TJLTM/MakeItRain/BOM/MakeItRain - Main Board - Bom.xls

Mfr Part Number (Input) | Quantity 1 | Mfr Part Number | Mouser Part Number | Manufacturer Name | Description | Unit Price 1 | Order Quantity | Order Unit Price | Min./Mult. | Availability | Lead Time in Days | Lead Time in Weeks | Lifecycle | NCNR | RoHS | Pb Free | Package Type | Package Quantity | Datasheet URL | Product Image | Design Risk
511-STPS3150RL | 4 | STPS3150RL | 511-STPS3150RL | STMicroelectronics | Schottky Diodes & Rectifiers Schottky Diodes & Rectifiers 3.0 Amp 150 Volt | $0.66 | 4 | $0.66 | 1\1 | 23,348 | 396 | 57 |  | No | Yes | No | REEL | 1,900 | https://www.mouser.com/datasheet/2/389/stps3150-1851493.pdf |  | Product has high popularity and is readily available.
579-MCP23008-E/P | 1 | MCP23008-E/P | 579-MCP23008-E/P | Microchip | Interface - I/O Expanders Interface - I/O Expanders In/Out I2C int | $1.54 | 1 | $1.54 | 1\1 | 1,979 | 301 | 43 |  | No | Yes | Yes | TUBE | 25 | https://www.mouser.com/datasheet/2/268/21919b-65915.pdf |  | Product has high popularity and is readily available.
512-2N7000 | 4 | 2N7000 | 512-2N7000 | onsemi | MOSFET MOSFET N-Channel Enhancement Mode Field Effect Transistor 60V, 200mA, 5 ohm | $0.52 | 4 | $0.52 | 1\1 |  | 423 | 61 |  | No | Yes | No | BULK | 10,000 | https://www.mouser.com/datasheet/2/308/1/NDS7002A_D-2317584.pdf |  | Product has high popularity and is readily available.
942-IRF9Z34NPBF | 5 | IRF9Z34NPBF | 942-IRF9Z34NPBF | Infineon | MOSFET MOSFET MOSFT PCh -55V -17A 100mOhm 23.3nC | $0.96 | 5 | $0.96 | 1\1 | 13,881 | 84 | 12 |  | No | Yes | Yes | TUBE | 1,000 | https://www.infineon.com/dgdl/Infineon-ApplicationNote_PowerMOSFET_SimulationModels-AN-v01_00-EN.pdf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 |  | Product has high popularity and is readily available.
512-BZX79C10 | 4 | BZX79C10 | 512-BZX79C10 | onsemi | Zener Diodes Zener Diodes 10V 0.5W Zener | $0.18 | 4 | $0.18 | 1\1 | 93,317 | 119 | 17 |  | No | Yes | No | BULK | 5,000 | https://www.mouser.com/datasheet/2/308/1/BZX79C2V4_D-2310197.pdf |  | Product has high popularity and is readily available.
859-LTV-846S | 1 | LTV-846S | 859-LTV-846S | Lite-On | Transistor Output Optocouplers Transistor Output Optocouplers Optocplr Phototrans 4-Channel | $1.00 | 1 | $1.00 | 1\1 | 92,716 | 84 | 12 |  | No | Yes | Yes | TUBE | 25 | https://www.mouser.com/datasheet/2/239/LTV_8X6_series-2887056.pdf |  | Product has high popularity and is readily available.
576-178.6165.0001 | 1 | 178.6165.0001 | 576-178.6165.0001 | Littelfuse | Fuse Holder Fuse Holder FUSEHOLDER FOR FLR | $4.62 | 1 | $4.62 | 1\1 | 11,055 | 147 | 21 |  | No | Yes | No | BULK | 100 | https://www.mouser.com/datasheet/2/240/Littelfuse_Fuse_Holder_ATO_FLR_pcb_Datasheet-1317199.pdf |  | Product has high popularity and is readily available.
179-TS0266160BK260LC | 1 | TS02-66-160-BK-260-LCR-D | 179-TS0266160BK260LC | CUI Devices | Tactile Switches Tactile Switches 6 x 6 mm, 16 mm Act Height, 260 gf, Black, Long Crimped, Through Hole, SPST, | $0.12 | 1 | $0.12 | 1\1 | 7,212 | 51 | 8 | New Product | No | Yes | No |  | 1,000 | https://www.mouser.com/datasheet/2/670/ts02-2586188.pdf |  | Product is new and is readily available.
651-17117251 | 1 | 1711725 | 651-1711725 | Phoenix Contact | Fixed Terminal Blocks Fixed Terminal Blocks 2P 5.08mm 90 DEG | $2.19 | 1 | $2.19 | 1\1 | 8,134 | 56 | 8 |  | No | Yes | No |  | 100 | https://www.phoenixcontact.com/us/products/1711725/pdf |  | Product has high popularity and is readily available.
652-3296W-1-504LF | 1 | 3296W-1-504LF | 652-3296W-1-504LF | Bourns | Trimmer Resistors - Through Hole Trimmer Resistors - Through Hole 3/8" 500Kohms Sealed Vertical Adjust | $2.43 | 1 | $2.43 | 1\1 | 2,464 | 49 | 7 |  | No | Yes | No | TUBE | 100 | https://www.mouser.com/datasheet/2/54/3296-776415.pdf |  | Product has high popularity and is readily available.
594-K224K20X7RF5UH5 | 4 | K224K20X7RF5UH5 | 594-K224K20X7RF5UH5 | Vishay | Multilayer Ceramic Capacitors MLCC - Leaded Multilayer Ceramic Capacitors MLCC - Leaded .22uF 50V 10% X7R 5mm LS | $0.43 | 4 | $0.43 | 1\1 | 19,750 | 105 | 15 |  | No | Yes | Yes | AMMO PACK | 2,500 | https://www.vishay.com/doc?45171 |  | Product has high popularity and is readily available.
595-OPA2340UA/2K5 | 1 | OPA2340UA/2K5 | 595-OPA2340UA/2K5 | Texas Instruments | Operational Amplifiers - Op Amps Operational Amplifiers - Op Amps Single-Supply Rail-to-Rail | $4.14 | 1 | $4.14 | 1\1 | 30,246 | 42 | 6 |  | No | Yes | No | REEL | 2,500 | https://www.ti.com/lit/pdf/sboz010a |  | Product has high popularity and is readily available.
603-CFR-25JT-52-22K | 4 | CFR-25JT-52-22K | 603-CFR-25JT-52-22K | YAGEO | Carbon Film Resistors - Through Hole Carbon Film Resistors - Through Hole 22 kOhms 250 mW 5% - 350/ +500 PPM / C | $0.10 | 4 | $0.10 | 1\1 | 16,256 | 196 | 28 |  | No | Yes | Yes | REEL | 5,000 | https://www.mouser.com/datasheet/2/447/YAGEO_CFR_datasheet_2021v0-3002993.pdf |  | Product has high popularity and is readily available.
603-CFR-25JT-52-100K | 4 | CFR-25JT-52-100K | 603-CFR-25JT-52-100K | YAGEO | Carbon Film Resistors - Through Hole Carbon Film Resistors - Through Hole 100 kOhms 250 mW 5% 0/-700PPM/ C | $0.10 | 4 | $0.10 | 1\1 | 41,401 | 196 | 28 |  | No | Yes | Yes | AMMO PACK | 5,000 | https://www.mouser.com/datasheet/2/447/YAGEO_CFR_datasheet_2021v0-3002993.pdf |  | Product has high popularity and is readily available.
603-CFR-25JT-52-10K | 7 | CFR-25JT-52-10K | 603-CFR-25JT-52-10K | YAGEO | Carbon Film Resistors - Through Hole Carbon Film Resistors - Through Hole 10 kOhms 250 mW 5% - 350/ +500 PPM / C | $0.11 | 7 | $0.11 | 1\1 | 1,447 | 196 | 28 |  | No | Yes | Yes | AMMO PACK | 5,000 | https://www.mouser.com/datasheet/2/447/YAGEO_CFR_datasheet_2021v0-3002993.pdf |  | Product has high popularity and is readily available.
603-CFR-25JT-52-330R | 5 | CFR-25JT-52-330R | 603-CFR-25JT-52-330R | YAGEO | Carbon Film Resistors - Through Hole Carbon Film Resistors - Through Hole 330ohm 5% 1/4W Carbon Film | $0.10 | 5 | $0.10 | 1\1 | 13,902 | 138 | 20 |  | No | Yes | Yes | REEL | 5,000 | https://www.mouser.com/datasheet/2/447/YAGEO_CFR_datasheet_2021v0-3002993.pdf |  | Product has high popularity and is readily available.
603-CFR-25JT-52-1M | 4 | CFR-25JT-52-1M | 603-CFR-25JT-52-1M | YAGEO | Carbon Film Resistors - Through Hole Carbon Film Resistors - Through Hole 1 MOhms 250 mW 5% -1500/ + 0 PPM / C | $0.10 | 4 | $0.10 | 1\1 | 10,713 | 171 | 25 |  | No | Yes | Yes | AMMO PACK | 5,000 | https://www.mouser.com/datasheet/2/447/YAGEO_CFR_datasheet_2021v0-3002993.pdf |  | Product has high popularity and is readily available.
603-CFR-25JT-52-15K | 1 | CFR-25JT-52-15K | 603-CFR-25JT-52-15K | YAGEO | Carbon Film Resistors - Through Hole Carbon Film Resistors - Through Hole 15Kohm 5% 1/4W Carbon Film | $0.10 | 1 | $0.10 | 1\1 | 5,583 | 110 | 16 |  | No | Yes | Yes | REEL | 5,000 | https://www.mouser.com/datasheet/2/447/YAGEO_CFR_datasheet_2021v0-3002993.pdf |  | Product has high popularity and is readily available.
603-CFR-25JT-52-120K | 1 | CFR-25JT-52-120K | 603-CFR-25JT-52-120K | YAGEO | Carbon Film Resistors - Through Hole Carbon Film Resistors - Through Hole | $0.10 | 1 | $0.10 | 1\1 | 1,758 | 112 | 16 |  | No | Yes | Yes |  |  | https://www.mouser.com/datasheet/2/447/YAGEO_CFR_datasheet_2021v0-3002993.pdf |  | Product has high popularity and is readily available.
603-CFR-25JT-52-47K | 2 | CFR-25JT-52-47K | 603-CFR-25JT-52-47K | YAGEO | Carbon Film Resistors - Through Hole Carbon Film Resistors - Through Hole 47Kohm 5% 1/4W Carbon Film | $0.10 | 2 | $0.10 | 1\1 | 1,723 | 95 | 14 |  | No | Yes | Yes | REEL | 5,000 | https://www.mouser.com/datasheet/2/447/YAGEO_CFR_datasheet_2021v0-3002993.pdf |  | Product has high popularity and is readily available.
CFR-25JT-52-2K2 | 2 | CFR-25JT-52-2K2 | 603-CFR-25JT-52-2K2 | YAGEO | Carbon Film Resistors - Through Hole Carbon Film Resistors - Through Hole 2.2 kOhms 250 mW 5% -350/ +500 PPM / C | $0.10 | 2 | $0.10 | 1\1 | 21,704 | 224 | 32 |  | No | Yes | Yes | AMMO PACK | 5,000 | https://www.mouser.com/datasheet/2/447/YAGEO_CFR_datasheet_2021v0-3002993.pdf |  | Product has high popularity and is readily available.
571-1-2199298-5 | 1 | 1-2199298-5 | 571-1-2199298-5 | TE Connectivity | IC & Component Sockets IC & Component Sockets 18P DIP SKT 300 CL LADDER | $0.38 | 1 | $0.38 | 1\1 | 7,079 | 88 | 13 |  | No | Yes | Yes | TUBE | 2,600 | https://www.mouser.com/catalog/additional/Tyco Electronics_1-1773906-9_DIP_Socket_QRG_012017.pdf |  | Product has high popularity and is readily available.
78-TLLG4400-AS12 | 1 | TLLG4400-AS12 | 78-TLLG4400-AS12 | Vishay | Standard LEDs - Through Hole Standard LEDs - Through Hole Green; 1.2mcd; 3mm 562-575nm; 1.9V Typ | $0.51 | 1 | $0.51 | 1\1 | 13,179 | 119 | 17 |  | No | Yes | Yes |  | 10,000 | https://www.vishay.com/doc?84892 |  | Product has high popularity and is readily available.
522-BS250P | 4 | BS250P | 522-BS250P | Diodes Incorporated | MOSFET MOSFET P-Chnl 45V | $0.89 | 4 | $0.89 | 1\1 | 6,900 | 314 | 45 |  | No | Yes | Yes | BULK | 4,000 | https://www.diodes.com/assets/Datasheets/BS250P.pdf |  | Product has high popularity and is readily available.
651-1714735 | 4 | 1714735 | 651-1714735 | Phoenix Contact | Fixed Terminal Blocks Fixed Terminal Blocks 3 POS 5.08mm SP. | $3.47 | 4 | $3.47 | 1\1 | 836 | 42 | 6 |  | No | Yes | No |  | 50 | https://www.phoenixcontact.com/us/products/1714735/pdf |  | Product has moderate popularity and is readily available.
517-929974-01-19-RK | 2 | 929974-01-16-RK | 517-929974-01-16-RK | 3M | Headers & Wire Housings Headers & Wire Housings 16 CON STR BRDMNT SKT | $2.61 | 2 | $2.61 | 1\1 | 1,389 | 35 | 5 |  | No | Yes | No |  | 360 | https://www.mouser.com/datasheet/2/1/991ec32a691ced7668842f5090ff38d9635d6388-2952179.pdf |  | Product has high popularity and is readily available.
