TJLTM/MakeItRain/Docs/HW Verification for BaseBoard.ods

Zone | Input | Output
1
2
3
4
LED
Button
Aux Voltage
VS Voltage
Extra IO | Test as Output
Z5
Z6
Z7
Z8
