TJLTM/MakeItRain/(threads)

Thread 1 (2021-10-10):

turn Power fets around to allow for a heat sink.

TJLTM, 2021-10-10:
if they are turned around then this will allow for a heat sink to be installed to allow more current.

TJLTM, 2021-10-12:
Did this i haven't designed the heat sink that will fit across all the FETs including the Reverse polarity protection fet

Closed 2021-10-12.

Thread 3 (2021-11-08):

Debounce the input pins

TJLTM, 2021-11-08:
they are a little touchy need to have a slight hardware mod to correct this along with some FW

TJLTM, 2021-11-25:
tested this with a hardware mod to the current boards this looks to be fixed.

Closed 2021-11-25.

Thread 4 (2021-11-22):

when local inputs are toggled with Current code this causes restart

TJLTM, 2021-11-22:
When triggering these ISR for the local inputs it causes a core to panic and thus causes a restart/reboot of the processor.

TJLTM, 2021-11-25:
In my laziness i was triggering an MQTT publish within a ISR for the Local input zone control. fixed that with some flag setting and updates outside of the ISR. It doesn't cause a core panic/restart with commit: 1574a7fd6202a83d2789cc866ac36614299d7460

Closed 2021-11-25.

Thread 5 (2021-11-22):

When starting initializing the Pins as outputs causes them to drive high and will trigger the outputs to be on for approx 0.5 seconds

TJLTM, 2021-11-22:
Not sure what i have to do to fix this issue. Could be in code or in hardware. Not sure if it can be fixed in either case without having a separate enable output circuit.

TJLTM, 2022-03-30:
so this may be a ESP-32 hardware quirk (one of many it seems) that you can't work around. It looks like when you setup pin-modes they drive the pins high for ~100 mS while the Pull-ups and all the other port stuff are set up.

Closed 2022-03-30.

Thread 6 (2021-12-30):

add opto-isolation to the Input Circuits.

TJLTM, 2021-12-30:
I use the same input on CampKeen and that has a way of burning out the GPIO If there is an external and separate Voltage source is used to trigger the Input. probably won't affect this board but can't hurt.

Closed 2022-02-02.

Thread 8 (2022-01-06):

update schematic so that spare pins include I2C bus

TJLTM, 2022-01-06:
i haven't looked yet. but i think i have to move some pins around as to have the I2C bus free to be used on a daughter board.

Closed 2022-02-02.

Thread 10 (2022-03-22):

RTC on version 1.0 hardware isn't working correctly

TJLTM, 2022-03-22:
i have to figure out if this is an ESP or hardware issue.

TJLTM, 2022-03-30:
working theory for this is in the fact that the power draw when on WIFI causes current limitations/voltage drop on the I2C bus that cause higher noise on the lines. This may require stronger Pull-ups on the I2C bus. or some other hardware modification to get the capacitance into spec.

TJLTM, 2022-04-08:
removing the DS3231 RTC and using the Internal RTC since there is a LIB for it.

Closed 2022-04-08.

Thread 16 (2022-04-19):

Design Daughter Board for Power

TJLTM, 2022-04-19:
due to trouble sourcing LM2597-5.0 chips I'm going to make the 5V power source a daughter/sub board that can be switched out to another chip if needed OR allow it to take in AC Voltage sources. I have not tested or tried that yet.

TJLTM, 2022-07-19:
design 3.3v output board as well. AC may not be able to be done as that may need to change out the reverse protection and zone outputs. i would have to switch from solid state to relay for that to be done.

TJLTM, 2022-10-06:
scratch that redesign for #22 shows that i no longer need to have 5v just 3.3v. way to resolve this is to remove 5v completely from the main board and if power is needed on the daughterboard they can pull power from that while leaving the main boards power alone.

TJLTM, 2023-04-26:
designed one in a separate repo https://github.com/TJLTM/LM2670SX-3.3-Carrier

Closed 2023-04-26.

Thread 21 (2022-06-13):

Investigate MPPT solar chargers

TJLTM, 2022-06-13:
Dogfooding one of these units and has caused the power subsystem to have faults. Pretty sure this is related to the PWM of this charger and i need to look at filtering the power.

TJLTM, 2022-10-06:
#22 and #16  will probably fix this one as the ESP32 is a power hungry little chip that needs ~4watts of power and the 2.5w that the reg can output causes it to burn out over time not the MPPT solar charger for the battery. will keep an eye on this after the power redeisng

TJLTM, 2023-05-16:
Closing this issue for now since. it looks like it was never MPPT chargers and the voltage regulator on the board. If issues come back up we'll reopen this issue and address it.

Closed 2023-05-16.

Thread 22 (2022-08-21):

on boot ESP doesn't finish booting and has a zone (3) stay on.

TJLTM, 2022-08-21:
investigating when i lost power and it came back up that makeitrain would not finish booting and would have zone 3 stay on.

TJLTM, 2022-08-21:
Add to Docs or fix in HW that the EN pin can't be left floating and must be tied high or snipped from Dev board to stop this. as well as removing one ground pin that seems to cause the same issue. that requires some further investigation.

TJLTM, 2022-08-23:
further investigation is showing that this may be a partial fix. to solve this problem may use another GPIO pin to enable the outputs

Closed 2023-05-19.

Thread 23 (2022-10-06):

rework the daughterboard templates.

TJLTM, 2022-10-06:
fixing the boot and pin issues will require these to be updated to work.

TJLTM, 2023-04-26:
updated and finished in #22 branch

Closed 2023-04-26.

Thread 24 (2022-12-20):

Go over CheckStoredData() for anything that could cause issues

TJLTM, 2022-12-20:
Check to see if an invalid state can be set in here and cause the ESP32 to crash.

Thread 25 (2023-01-03):

Add Safety for 3.3v input to board

TJLTM, 2023-01-03:
Realized that the input to the 3.3v needs protection against
-- Overvoltage 3.7
-- reverse polarity?

TJLTM, 2023-05-16:
Closing because of the following reasons
* reverse polarity is down stream and if someone hooks up things incorrectly.... well bad things happen
*  Overvoltage protection could be added but adds complexity and uses up some real estate and is a bit of edge case since if the regulator goes bad in more other systems it's fired.

Closed 2023-05-16.

Thread 26 (2023-01-06):

Replace OPA2340PA with OPA2340UA/2K5

TJLTM, 2023-01-06:
OPA2340PA is no longer made.

TJLTM, 2023-01-15:
OPA2340UA/2K5 is an SMT/D pin compatible package of the same family, for 1.3.x boards i'm going to use a dip to smt/d pcb. 1.4 boards are going to get this fix.

TJLTM, 2023-04-26:
replaced in #22 branch

Closed 2023-04-26.

Thread 27 (2023-03-27):

Fix Wifi Reconnect Logic

TJLTM, 2023-03-27:
Needs to be reworked that it will continue to try but at a backed off rate.
Current workflow is after x times of trying it stops and turns on AP and BT (when BT feature is done that is)

Keep X tries and then turn on BT and AP mode but continue trying and if it reconnects then turn off BT/AP if they were already disabled.

Closed 2024-01-28.

Thread 31 (2023-05-23):

HW Determine if input circuit is faulty or if PCB routing is to blame

TJLTM, 2023-05-23:
Inputs on 1.3.2/3 boards act as if shorted.

TJLTM, 2023-06-12:
check your parts the parts i bought for this after searching their datasheets and manu dont' say that the -BU and the -SP part numbers denotes a 3P being a single connection instead of 3P that are independent.

Closed 2023-07-14.

Thread 32 (2023-07-25):

HW Improvement: Input Impedance

TJLTM, 2023-07-25:
add a Nchannel fet after the Pchannel on the input to raise the input impedance a merger of the last and current designs. Doesn't need to be implemented for release but will fix other use cases that i only seem to have.

Thread 33 (2024-02-04):

Local control toggle and MQTT update bug

TJLTM, 2024-02-04:
when enabled MQTT update goes into a loop for the update and partially locks up the ESP32
