TJLTM/MakeItRain/(list of files, drawings)

Other design files:
Hardware/MIR-InputMod/MIR-InputMod.dsn
