TJLTM/MakeItRain/Code/Tools And Test/HardwareValidation/HardwareValidation.ino

#include <Wire.h>
#include <Adafruit_MCP23X08.h>

#define I2C_SDA_PIN 23
#define I2C_SCL_PIN 22
Adafruit_MCP23X08 GPIOEX;
bool GrootToGo = true;

#define VSVoltagePin 33
#define AUXVoltagePin 32
#define ResetButton 25
#define LEDOut 27

#define Zone1Input 34
#define Zone2Input 35
#define Zone3Input 36
#define Zone4Input 39

void setup() {
  Serial.begin(9600);
  //Wire.begin(I2C_SDA_PIN, I2C_SCL_PIN);
  //Wire.setClock(100000);
  if (!GPIOEX.begin_I2C()) {
    Serial.println("Error can not communicate to MCP23008");
    GrootToGo = false;
  }
  else {
    GPIOEX.pinMode(0, OUTPUT); //Zone 1
    GPIOEX.pinMode(1, OUTPUT); //Zone 2
    GPIOEX.pinMode(2, OUTPUT); //Zone 3
    GPIOEX.pinMode(3, OUTPUT); //Zone 4
    GPIOEX.pinMode(4, OUTPUT); //Zone 5
    GPIOEX.pinMode(5, OUTPUT); //Zone 6
    GPIOEX.pinMode(6, OUTPUT); //Zone 7
    GPIOEX.pinMode(7, OUTPUT); //Zone 8
  }

  pinMode(LEDOut, OUTPUT);
  pinMode(ResetButton, INPUT);
  pinMode(Zone1Input, INPUT);
  pinMode(Zone2Input, INPUT);
  pinMode(Zone3Input, INPUT);
  pinMode(Zone4Input, INPUT);
}

void loop() {
  //ButtonCheck();
  //ReadADCs();
  //ReadAllInputs();
  //ReadAllInputsIndivialDisplay();
  //OutputWalk();
  
  /*
    OutputBlink(0,2000);
    OutputBlink(1,2000);
    OutputBlink(2,2000);
    OutputBlink(3,2000);
    OutputBlink(4,2000);
    OutputBlink(5,2000);
    OutputBlink(6,2000);
    OutputBlink(7,2000);
  */
}

void ButtonCheck() {
  int ButtonRead = digitalRead(ResetButton);
  Serial.print("Reset Button State:");
  Serial.println(ButtonRead);
  digitalWrite(LEDOut, digitalRead(ResetButton));
}

void ReadADCs() {
  Serial.print("AUX Voltage:");
  Serial.println(analogRead(AUXVoltagePin));
  Serial.print("VS Voltage DN:");
  Serial.println(analogRead(VSVoltagePin));
  float Voltage = (30.954 / 4095) * analogRead(VSVoltagePin);
  Serial.print("VS Voltage Calc:");
  Serial.println(Voltage);
  delay(2500);
}

void ReadAllInputs() {
  byte Inputs;

  bitWrite(Inputs, 0, digitalRead(Zone1Input));
  bitWrite(Inputs, 1, digitalRead(Zone2Input));
  bitWrite(Inputs, 2, digitalRead(Zone3Input));
  bitWrite(Inputs, 3, digitalRead(Zone4Input));

  Serial.print("Inputs:");
  Serial.println(Inputs);
  delay(1000);
}


void ReadAllInputsIndivialDisplay() {
  Serial.print("Input1:");
  Serial.println(digitalRead(Zone1Input));

  Serial.print("Input2:");
  Serial.println(digitalRead(Zone2Input));

  Serial.print("Input3:");
  Serial.println(digitalRead(Zone3Input));

  Serial.print("Input4:");
  Serial.println(digitalRead(Zone4Input));
  
  delay(1000);
}

void OutputWalk() {
  for (int x = 0; x < 8; x++) {
    OutputBlink(x, 2000);
  }
}

void OutputBlink(int PortNumber, float Time) {
  String Message = "Zone " + String(PortNumber) + " Output ";
  Serial.println(Message + "High");
  SetOutput(PortNumber, HIGH);
  delay(Time);
  Serial.println(Message + "LOW");
  SetOutput(PortNumber, LOW);
  delay(Time);
}


void SetOutput(int PortNumber, bool State) {
  if (GrootToGo == true) {
    GPIOEX.digitalWrite(PortNumber, State);
  }
  else {
    Serial.println("Can Not communicate with MCP23008");
  }
}
