TJLTM/MakeItRain/(commit log)

2021-09-20 initial blank HW Project
    [MakeItRain.kicad_pcb, MakeItRain.sch]
2021-09-22 stopping point as i need to test the voltage sensor and also see what the power draw is for this so far. I may have to bump the power reg to something with more power.
    [file61506092.sch, file6158F2C3.sch]
2021-09-26 WIP to test some hardware designs.
    [MakeItRain.kicad_pcb, MakeItRain.sch]
2021-10-05 wip for layout
    [MakeItRain.kicad_pcb, MakeItRain.sch, file61506092.sch]
2021-10-05 updated to have only up to 4 additional zones with a separate board.
    [MakeItRain.kicad_pcb, MakeItRain.sch]
2021-10-06 Routing Done need to add some more documentation to the board via silkscreen.
    [MakeItRain.kicad_pcb, MakeItRain.sch, file61506092.sch]
2021-10-07 Fixed a few fuck up on the board and schematic. a label wasn't correct and thus wasn't routed. Changed the VDC power to the zones from a 40mil trace to a plane. added silkscreen stuff to the board.
    [MakeItRain-B_Cu.gbr, MakeItRain-B_Mask.gbr, MakeItRain-B_Paste.gbr, MakeItRain-B_SilkS.gbr, MakeItRain-Edge_Cuts.gbr, MakeItRain-F_Cu.gbr, MakeItRain-F_Mask.gbr, MakeItRain-F_Paste.gbr]
2021-10-07 fixed the silkscreen stuff on the fab files
    [MakeItRain-B_Cu.gbr, MakeItRain-B_Mask.gbr, MakeItRain-B_Paste.gbr, MakeItRain-B_SilkS.gbr, MakeItRain-Edge_Cuts.gbr, MakeItRain-F_Cu.gbr, MakeItRain-F_Mask.gbr, MakeItRain-F_Paste.gbr]
2021-10-12 WIP for HW fixed a few things like positions of the Power Fets so they can have a Heat sink. Added holes for mounting daughter boards. Feed Trace to Q1 was beefed up to wide zone from 10mils this is 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
    [MakeItRain.kicad_pcb]
2021-10-21 putting in correct pins and Hardware Verification sketch.
    [HardwareValidation.ino]
2021-10-21 updated resistor values on the boards that weren't defined.
    [MakeItRain.kicad_pcb, MakeItRain.sch]
2021-10-24 adding bom and
    [MakeItRain.csv]
2021-10-25 fixing a hole placement and routing.
    [MakeItRain.kicad_pcb]
2021-10-25 FW for using interrupts for the local control. needs to be tested.
2021-10-27 updated some missing values on the schematic.
    [MakeItRain.sch, file61506092.sch]
2021-10-30 updated fab files and some values on the schematic. this is to fix the problem with grounding one of the ground pins and it affecting the dev board running and being able to load.
    [MakeItRain-B_Cu.gbr, MakeItRain-B_Mask.gbr, MakeItRain-B_Paste.gbr, MakeItRain-B_SilkS.gbr, MakeItRain-Edge_Cuts.gbr, MakeItRain-F_Cu.gbr, MakeItRain-F_Mask.gbr, MakeItRain-F_Paste.gbr]
2021-11-02 fixed the battery voltage read. removing some comments and removing outputs 7 & 8 as those won't be needed changing the ideas for the Daughterboard.
2021-11-14 adding timer and whatnot.
2021-11-14 fixed mqtt communication need to get the mqtt to zone switch on change to work.
2021-11-16 adding the debounce caps haven't moved some stuff around on the board to fit these in.
    [MakeItRain.kicad_pcb, file61506092.sch]
2021-11-17 added the debounce caps to the layout and updated the fab files for this version.
    [MakeItRain-B_Cu.gbr, MakeItRain-B_Mask.gbr, MakeItRain-B_Paste.gbr, MakeItRain-B_SilkS.gbr, MakeItRain-Edge_Cuts.gbr, MakeItRain-F_Cu.gbr, MakeItRain-F_Mask.gbr, MakeItRain-F_Paste.gbr]
2021-11-25 Some performance/message throttling is probably needed but this is currently working. Tested with a debounce modification on the input and that seems to have fixed the input bouncing problem. I see m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
2022-01-09 update to kicad 6.0 and start on adding in opto-isolationg to the inputs as to protect the processor GPIO
    [MakeItRain.kicad_pcb]
2022-01-09 working on adding the opto-isolators
    [MakeItRain.kicad_sch, file61506092.kicad_sch]
2022-01-09 wip for hardware
    [InputIsolation.kicad_sch, MakeItRain.kicad_pcb, MakeItRain.kicad_sch, Power.kicad_sch, VoltageSensors.kicad_sch, file61506092.kicad_sch]
2022-01-10 cleaning up the files after the KIcad Project upgrade
    [MakeItRain.csv, MakeItRain.sch, file61506092.sch, file6158F2C3.sch]
2022-01-25 wip for input fix.
    [InputIsolation.kicad_sch, MakeItRain.kicad_pcb, MakeItRain.kicad_sch, Power.kicad_sch, VoltageSensors.kicad_sch, file61506092.kicad_sch]
2022-02-02 pre routing
    [InputIsolation.kicad_sch, MakeItRain.kicad_pcb, MakeItRain.kicad_sch, VoltageSensors.kicad_sch, file61506092.kicad_sch]
2022-02-02 fixed some redundant routing
    [MakeItRain.kicad_pcb]
2022-02-02 updated fab files
    [MakeItRain-B_Cu.gbr, MakeItRain-B_Mask.gbr, MakeItRain-B_Paste.gbr, MakeItRain-B_Silkscreen.gbr, MakeItRain-Edge_Cuts.gbr, MakeItRain-F_Cu.gbr, MakeItRain-F_Mask.gbr, MakeItRain-F_Paste.gbr]
2022-02-19 updating the fab files so they can be sent off.
    [MakeItRain-B_Cu.gbr, MakeItRain-B_Mask.gbr, MakeItRain-B_Paste.gbr, MakeItRain-B_Silkscreen.gbr, MakeItRain-Edge_Cuts.gbr, MakeItRain-F_Cu.gbr, MakeItRain-F_Mask.gbr, MakeItRain-F_Paste.gbr]
2022-02-21 updating fab files.
    [MakeItRain-B_Adhesive.gbr, MakeItRain-B_Courtyard.gbr, MakeItRain-B_Cu.gbr, MakeItRain-B_Fab.gbr, MakeItRain-B_Mask.gbr, MakeItRain-B_Paste.gbr, MakeItRain-Edge_Cuts.gbr, MakeItRain-F_Adhesive.gbr]
2022-03-21 adding HTML BOM
2022-03-22 updated values for the InputIsolation circuits. updated the PCB values and BOM. Updating the Hardware Validation program.
    [InputIsolation.kicad_sch, MakeItRain.kicad_pcb, MakeItRain.kicad_sch]
2022-03-22 working on fixing the verification program. updating the main fw to have the correct pins. removing the daughterboard sensing and adding RTCBattery voltage sensing.
    [HardwareValidation.ino]
2022-03-29 switching the interrupts to be failing as the inputs are inverted from previous design.
2022-03-29 autoformat, added max zone on time (to cover connection loss after turned on), fixed Voltage Readings.
2022-03-30 switching out Serial for a central place for that. changed the mqtt connection name to be that of the ID so there isn't a conflict on the MQTT server. fixed some timer issues and added a 15 second ti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
2022-03-30 autoformat, added Wifitry again timer Tries every 15 mins after max attempts in a row, a five second timer for throttling the can't connect to wifi message, fixed voltage reads to be every 30 seconds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
2022-04-01 production build for ESP32
2022-04-01 reduced file names for ESP32
2022-04-02 changing the name of the 30 second timer to Votlage timer and changing from 30 seconds to every 2 mins. may make this configurable.
2022-04-03 organizing some code. putting in AP framework and logic. adding in Settings and Reset functions. IP Settings.
2022-04-09 working on factory resets and setting up default information. along with adding in a battery mode to incorporate sleep modes (start of nothing works with it yet)
2022-04-09 removing RTC battery voltage and adding Battery mode to system settings.
2022-04-09 wip for removing the external RTC and moving the power stuff around to make it easier to install into enclosure.
    [MakeItRain.kicad_pcb, MakeItRain.kicad_sch]
2022-04-10 continuing on moving the parts around the board to make installation into the SERPAC RBF63XXXX series enclosure easier.
    [MakeItRain.kicad_pcb]
2022-04-11 adding v0.1 HW support since i'm Deving some stuff on those boards, fixing some of the WIFI/AP mode stuff. Removing RTC Battery Stuff.
2022-04-11 Routed. DRC'ed. and Fab Files have been updated.
    [MakeItRain-B_Cu.gbr, MakeItRain-B_Mask.gbr, MakeItRain-B_Paste.gbr, MakeItRain-B_Silkscreen.gbr, MakeItRain-Edge_Cuts.gbr, MakeItRain-F_Cu.gbr, MakeItRain-F_Mask.gbr, MakeItRain-F_Paste.gbr]
2022-04-11 stubbed in some AP mode stuff. cleaned up some unused timer vars and stubbing in battery mode stuff.
2022-04-12 fixed the oldhw pin def and logic.
2022-04-15 due to lack of chips (LM2597) i'm switching (no pun intended) to having the power system be a daughter board that can be plugged in once i find some replacements.
    [MakeItRain.kicad_pcb, MakeItRain.kicad_sch, Power.kicad_sch]
2022-04-19 bumped Version on silkscreen to 1.2. Still need to place some mounting holes if needed for the power daughter board.
    [MakeItRain.kicad_pcb]
2022-04-22 trying a behavior change. When starting up and subscribing to MQTT not pushing the current status of the outputs letting whats on the MQTT topic over ride and set local.
2022-05-01 autoformat. yes i do that a lot. white space formatting pleases my python writing mind. working on the wifi and ap connection stuff and how it's suppose to work. currently it will turn on the AP mode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
    [MakeItRain-FW.ino]
2022-05-13 adding a daughterboard blank kicad project with board outline.
    [MakeItRain - DaughterBoard Blank.kicad_pcb, MakeItRain - DaughterBoard Blank.kicad_sch]
2022-05-27 initial working on wifi stuff. some logic for wifi vs ap and other bugs that may have been related to a dying ESP32
    [MakeItRain-FW.ino]
2022-05-28 fixed some of the MQTT stuff and moved a lot of logic down into one function that is called. fixed some of the ISR stuff so it won't be called on start up. added a debug heartbeat serial print for th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
    [MakeItRain-FW.ino]
2022-05-28 added feature to set IDs added the print out of wifi ip on serial. removed once try from MQTT send if disconnected. this probably isn't that important because when it comes back online with mqtt it w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
2022-05-30 removing some print statements streamlining MQTTSend to only try to send with it's enabled and the client is connected. added logic that forces the AP on if the Wifi is turned off.
2022-07-06 updating the fab files. and removing hte ones that aren't needed.
    [MakeItRain-B_Adhesive.gbr, MakeItRain-B_Courtyard.gbr, MakeItRain-B_Cu.gbr, MakeItRain-B_Fab.gbr, MakeItRain-B_Mask.gbr, MakeItRain-B_Paste.gbr, MakeItRain-B_SilkS.gbr, MakeItRain-B_Silkscreen.gbr]
2022-07-11 updated Silkscreen to have the power header values. updated Fab Files.
    [MakeItRain-B_Cu.gbr, MakeItRain-B_Mask.gbr, MakeItRain-B_Paste.gbr, MakeItRain-B_Silkscreen.gbr, MakeItRain-Edge_Cuts.gbr, MakeItRain-F_Cu.gbr, MakeItRain-F_Mask.gbr, MakeItRain-F_Paste.gbr]
2022-07-19 Starting on Zone expansion daughter board.
    [MakeItRain - DaughterBoard Blank.kicad_pcb]
2022-07-19 moved fab files into sub folder for main board added to schematics for zones. copy pasta! need to place and route on PCB
    [MakeItRain - DaughterBoard Blank.kicad_pcb, MakeItRain - DaughterBoard Blank.kicad_sch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]
2022-07-19 adding support for Zone Expansion daughter board to FW finished daughter board design and pcb layout added fab files for zone expansion daughter board
    [MakeItRain - DaughterBoard Blank-B_Cu.gbr, MakeItRain - DaughterBoard Blank-B_Mask.gbr, MakeItRain - DaughterBoard Blank-B_Paste.gbr, MakeItRain - DaughterBoard Blank-B_Silkscreen.gbr, MakeItRain - DaughterBoard Blank-Edge_Cuts.gbr, MakeItRain - DaughterBoard Blank-F_Cu.gbr, MakeItRain - DaughterBoard Blank-F_Mask.gbr, MakeItRain - DaughterBoard Blank-F_Paste.gbr]
2022-07-20 updating BOM removing some old hardware defs from the code fixing the wip for expansion zones.
    [MakeItRain-FW.ino]
2022-08-23 Update MakeItRain-FW.ino
    going over some of the ESP32 docs and seeing that some pins will have to be remapped as they are causing some issues. sometimes these chips aren't worth the headaches they cause with all their gotchas.
    [MakeItRain-FW.ino]
2022-09-29 working on pin reassignment to fix the stupid stupid ways that esp32 are designed in hardware that require much in way of digging through docs cause not all gpio are created equal.
    [MakeItRain.kicad_sch, VoltageSensors.kicad_sch, file61506092.kicad_sch]
2022-09-29 cleaned up PCB of traces that have been deleted in the schematic.
    [MakeItRain.kicad_pcb]
2022-09-29 min updates on schem. wip
    [MakeItRain.kicad_sch, file61506092.kicad_sch]
2022-10-02 starting to add in the mcp23008 to get around the lack of pins or "special" pins that will fuck up designs. stupid ESP32s
    [MakeItRain.kicad_sch, file61506092.kicad_sch]
2022-10-02 i think i have the pins finally figured out. Need to breadboard this setup to make sure it works.
    [MakeItRain.kicad_sch, VoltageSensors.kicad_sch]
2022-10-05 replacing the daughterboard plug
    [MakeItRain.kicad_sch]
2022-10-06 working on getting the test code for the MCP23008 into the fw. working on the pins and getting all of that stuff placed on the PCB.
    [MakeItRain.kicad_pcb, MakeItRain.kicad_sch]
2022-10-07 removed the 5V on the baseboard and daughterboard plug.
    [MakeItRain.kicad_pcb, MakeItRain.kicad_sch, Power.kicad_sch]
2022-10-07 fixed the 3d shapes for various parts
    [MakeItRain.kicad_pcb]
2022-10-07 updating some routes, updating the already done daughterboard and updating the blank layout for both.
    [MakeItRain - DaughterBoard Blank.kicad_pcb, MakeItRain - DaughterBoard Blank.kicad_sch, MakeItRain.kicad_pcb]
2022-10-23 Moving into the prototyping testing this deisgn completely phase.
    changes
    * remapping some pins cause i forgot that ADC2 can not be used while using wifi.
    * adding the TH version of the MCP230008 as i don't know the availability of these chips can populate one or the other
    * removed zones 5-8 in the code since i hhaven't figured out the daughter board yet. Code not included can be buggy
    [MakeItRain.kicad_pcb, MakeItRain.kicad_sch, VoltageSensors.kicad_sch]
2022-11-27 fixing this testing verification code to be in line with the changes made. *Adding MCP23008 support *Removing RTC testing as that is internal to the ESP32
    [HardwareValidation.ino]
2022-11-28 moving some things around.
    [MakeItRain.kicad_pcb]
2022-11-28 fixed the MCP code.
    [HardwareValidation.ino]
2022-11-28 placing parts
    [MakeItRain.kicad_pcb]
2022-12-12 partial routing need to finish out the remainder.
    [MakeItRain.kicad_pcb]
2022-12-13 almost finished some routes
    [MakeItRain.kicad_pcb]
2022-12-14 Finished routing, DRC'ed and new Fab Files. Need one more once over to check before sending off to FAB
    [MakeItRain-B_Cu.gbr, MakeItRain-B_Mask.gbr, MakeItRain-B_Paste.gbr, MakeItRain-B_Silkscreen.gbr, MakeItRain-Edge_Cuts.gbr, MakeItRain-F_Cu.gbr, MakeItRain-F_Mask.gbr, MakeItRain-F_Paste.gbr]
2022-12-20 * Adding Doc for whats stored in eeprom * fixing some names for items stored in eeprom * moving some of the code around for house keeping.
    [stored settings.ods]
2022-12-31 updated BOM
2023-01-05 in the process of cleaning up the HardwareValidation.ino and fixing a major fuck up for the board. misread a pin header.
    [MakeItRain.kicad_sch]
2023-01-05 fixed GND connected to CMD pin * updated schematic * fixed PCB routing * updated Fab files * bumped board rev to 1.3.1
    [MakeItRain-B_Cu.gbr, MakeItRain-B_Mask.gbr, MakeItRain-B_Paste.gbr, MakeItRain-B_Silkscreen.gbr, MakeItRain-Edge_Cuts.gbr, MakeItRain-F_Cu.gbr, MakeItRain-F_Mask.gbr, MakeItRain-F_Paste.gbr]
2023-01-10 adding checklist for base board
    [HW Verification for BaseBoard.ods]
2023-02-26 upgrading the project to KiCAD 7
    [InputIsolation.kicad_sch, MakeItRain.kicad_pcb, MakeItRain.kicad_sch, Power.kicad_sch, VoltageSensors.kicad_sch, file61506092.kicad_sch]
2023-03-03 upgrade to kicad 7, updated bom/ibom.html
2023-04-10 adding some MCP can't be communicated to failure checks and bypass logic and error posting. Needs some more checks.
    [MakeItRain-FW.ino]
2023-04-17 WIP - Pre Re-Routing and other Tweaks.
    * Removed SMD package for the MCP23008
    * removed routings to fix the routes for I2C bus
    * flipped rx/tx with SDA/SCL on the expansion port to make routing easier.
    [MakeItRain.kicad_pcb, MakeItRain.kicad_sch, file61506092.kicad_sch]
2023-04-17 tweaking Test Code/Tools And Test/HardwareValidation/HardwareValidation.ino
    * adding I2C bus communication problem notifications
    * testing some i2c bus speed settings.
    [HardwareValidation.ino]
2023-04-18 wip for routing
    [MakeItRain.kicad_pcb]
2023-04-25 fixing routings
    [MakeItRain.kicad_pcb]
2023-04-26 MakeItRain * Main Board Fixed Routing. * replaced Opamp with the part that i can get as the old one is EOL * generated all the fab files i need. * updated the daughter plug witht eh i2c ttl flip * fi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
    MakeItRain - DaughterBoard - Zone Expansion
    * updated the daughter plug witht eh i2c ttl flip
    * fixed some of the routings
    * generated new fab files
    * DRC'ed the board
    [InputIsolation.kicad_sch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]
2023-04-29 Updating HTML assembly bom adding Mouser generated bom
    [MakeItRain - 4 Zone Expansion - Bom.xls, MakeItRain - Maine Board - Bom.xls]
2023-05-06 removing a timer that isn't used.
2023-05-06 updating the position of one daughter board mounting holes.
    [MakeItRain - DaughterBoard Blank-B_Cu.gbr, MakeItRain - DaughterBoard Blank-B_Mask.gbr, MakeItRain - DaughterBoard Blank-B_Paste.gbr, MakeItRain - DaughterBoard Blank-B_Silkscreen.gbr, MakeItRain - DaughterBoard Blank-Edge_Cuts.gbr, MakeItRain - DaughterBoard Blank-F_Cu.gbr, MakeItRain - DaughterBoard Blank-F_Mask.gbr, MakeItRain - DaughterBoard Blank-F_Paste.gbr]
2023-05-06 bumped board version to 1.3.3 amd updated FAB files
    [MakeItRain-B_Cu.gbr, MakeItRain-B_Mask.gbr, MakeItRain-B_Paste.gbr, MakeItRain-B_Silkscreen.gbr, MakeItRain-Edge_Cuts.gbr, MakeItRain-F_Cu.gbr, MakeItRain-F_Mask.gbr, MakeItRain-F_Paste.gbr]
2023-05-13 Updating the I2C pullup resistor values to 2.2K * updated BOM/MakeItRain - Maine Board - Bom.xls * updated schematics and layout values * update ibom.html
    [MakeItRain - Maine Board - Bom.xls, MakeItRain.kicad_pcb, MakeItRain.kicad_sch]
2023-05-13 updating BOM/MakeItRain - Maine Board - Bom.xls to have Socket for MCP23008
    [MakeItRain - Maine Board - Bom.xls]
2023-05-19 updating BOM/MakeItRain - Maine Board - Bom.xls
    [MakeItRain - Maine Board - Bom.xls]
2023-06-02 imput redesign
    [InputIsolation.kicad_sch, MakeItRain.kicad_pcb, MakeItRain.kicad_sch, file61506092.kicad_sch]
2023-06-02 1.4.0 routed and updated fab files
    [MakeItRain-B_Cu.gbr, MakeItRain-B_Mask.gbr, MakeItRain-B_Paste.gbr, MakeItRain-B_Silkscreen.gbr, MakeItRain-Edge_Cuts.gbr, MakeItRain-F_Cu.gbr, MakeItRain-F_Mask.gbr, MakeItRain-F_Paste.gbr]
2023-07-18 adding voltage conversion printout
2023-07-19 Finishing the 1.4.0 HW Paperwork
    [MakeItRain - Main Board - Bom.xls]
2023-08-07 adding some more print statements for status
2023-08-07 adding a input input impedance mod board
    [MIR-InputMod.dsn, MIR-InputMod.kicad_pcb, MIR-InputMod.kicad_sch]
2023-08-10 Multiple bug fixes
    * Fixed MQTT circular post/get set for zones
    * added Serial prints for status
    * Aligned all of the read/set outputs for indexing. no +1 -1 madness unless dealing with MQTT
    [MakeItRain-FW.ino]
2023-08-11 lots of stuff fixed
    Fixed wifi reconnection logic one of the biggest pains in the ass.
    fixed an MQTT connection bug when it comes back on
    changed the workflow for the wifi reconnection logic
    [MakeItRain-FW.ino]
2023-08-11 Moving the assorted Hardware designs into a Hardware Folder
    [InputIsolation.kicad_sch, MIR-InputMod.dsn, MIR-InputMod.kicad_pcb, MIR-InputMod.kicad_sch, MakeItRain - DaughterBoard Blank.kicad_pcb, MakeItRain - DaughterBoard Blank.kicad_sch, MakeItRain.kicad_pcb, MakeItRain.kicad_sch]
2023-08-13 Fixes
    * LocalControlLockout
    ** feature has been renamed LocalControlToggle
    ** Fixed input read and post when the Control Toggle is disabled
    ** This feature is probably going to have to be changed to have the Inputs read via interrupts so that the post to MQTT will be immediate
    * AutoFormat
    * Bumped version to 0.1.0 from 0.0.8
    * Added Read AUX Voltage input read and post to MQTT
    * Voltage MQTT topic changed back to ../Voltage from ../Voltage/
    [MakeItRain-FW.ino, MakeItRain-SetInfo.ino]
2023-08-13 Because i was lazy and didn't test my code completely i'm disabling the input code as it's broken and causes a core crash
    [MakeItRain-FW.ino]
2023-08-13 adding the missing memory keys
    [MakeItRain-SetInfo.ino]
2023-08-13 adding two helpful pieces of information 1. Assigning the Hostname to be the same as the AP name 2. Print out Local IP - great for DHCP mode
2023-08-14 Changing Votlage Timer to 60 seconds insetad of 120
2023-08-30 Added hostname print out when connected to wifi
2023-08-31 Added Error checking * a bug happened where it would try to turn off the MCP23008 off via the zone timer check if it wasn't connected * added a NO SSID WIFI password was added to the memory space or 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
    [MakeItRain-FW.ino, MakeItRain-SetInfo.ino]
2024-02-09 removed all of the Current WEB Server and NodeJS implementation as there will not be enough space to use all that fancy stuff without switching to a different ESP module.
